SteveLRojas/LandShark/README.md

# LandShark
FPGA board for motor control applications. Compatible with the Alchemy board.
