SteveLRojas/LandShark/LandShark_ADC_Bridge/BOM.ods

Part | #Needed | #Owned | Satisfied? | Location
ADS7052 | 4 | 10 | TRUE | ADC Box
XC6219B332MR | 1 | 100 | TRUE | Regulator Box
ME6211C25M5G-N | 1 | 20 | TRUE | Regulator Box
Capacitor 10u 1206 | 3 | 100 | TRUE | Project Box
Capacitor 1u 0805 | 12 | 300 | TRUE | Box 7
Capacitor 470p 0603 | 4 | 1000 | TRUE | Small Capacitor Box
Resistor 330 ohm 0603 | 4 | 5000 | TRUE | Reel Box
Ferrite bead 0805 | 1 | 20 | TRUE | Project Box
Pin header 1x3 1.27mm | 1 | 50 | TRUE | Connector Box
Pin socket 2x20 2.54mm | 1 | 12 | TRUE | Connector Box
Pin header 2x22 2.54mm | 1 | 4 | TRUE | Connector Box
