SteveLRojas/LandShark/LandShark/BOM.ods

Part | #Needed | #Owned | Satisfied? | Location
EP4CE15E22C8N | 1 | 2 | TRUE | Project Box
AMS1117-3.3 | 1 | 5 | TRUE | Voltage Regulator Box
AMS1117-2.5 | 1 | 5 | TRUE | Voltage Regulator Box
AZ1117-1.2 | 1 | 5 | TRUE | Voltage Regulator Box
W25Q16JVSNIQ | 1 | 10 | TRUE | Project Box
75LVC1G17 | 6 | 10 | TRUE | Project Box
PMBT3906 | 4 | 1000 | TRUE | Project Box
32MHz oscillator 3225 | 1 | 10 | TRUE | Crystal Box
50MHz oscillator 3225 | 1 | 10 | TRUE | Crystal Box
FJ2481BH (Hex display) | 1 | 8 | TRUE | Project Box
LL3301NF065QG (button) | 4 | 20 | TRUE | Project Box
Test point 2.5mm 1mm | 4 | 40 | TRUE | Project Box
Capacitor 100u 6.3x5.2 | 2 | 10 | TRUE | Project Box
Capacitor 10u 1206 | 2 | 10 | TRUE | Project Box
Capacitor 47u 1206 | 2 | 10 | TRUE | Project Box
Capacitor 1u 0805 | 4 | 200 | TRUE | Box 7
Capacitor 0.1u 0805 | 33 | 100 | TRUE | Project Box
Resistor 5K6 0805 | 8 | 500 | TRUE | Box 8
Resistor 220 0805 | 8 | 4000 | TRUE | Box 8
Resistor 10K 0805 | 14 | 100 | TRUE | Box 8
Resistor 33 0805 | 2 | 20 | TRUE | Box 8
Resistor 1K 0805 | 1 | 10 | TRUE | Project Box
Socket 2.54mm 2x20 angled | 1 | 10 | TRUE | Connector Box
Socket 2.54mm 6x2 angled | 1 | 10 | TRUE | Connector Box
Pin header 2.54mm 2x5 shrouded | 2 | 10 | TRUE | Connector Box
Pin header 2.54mm 2x20 angled | 1 | 10 | TRUE | Connector Box
Pin header 2.54mm 1x5 | 2 | 20 | TRUE | Connector Box
Ferrite bead 0805 | 4 | 900 | TRUE | Project Box
