SteveLRojas/LandShark/LandShark_ADC_Bridge/LandShark_ADC_Bridge.kicad_pcb

## KiCad design LandShark_ADC_Bridge/LandShark_ADC_Bridge.kicad_pcb (2026-02-09)

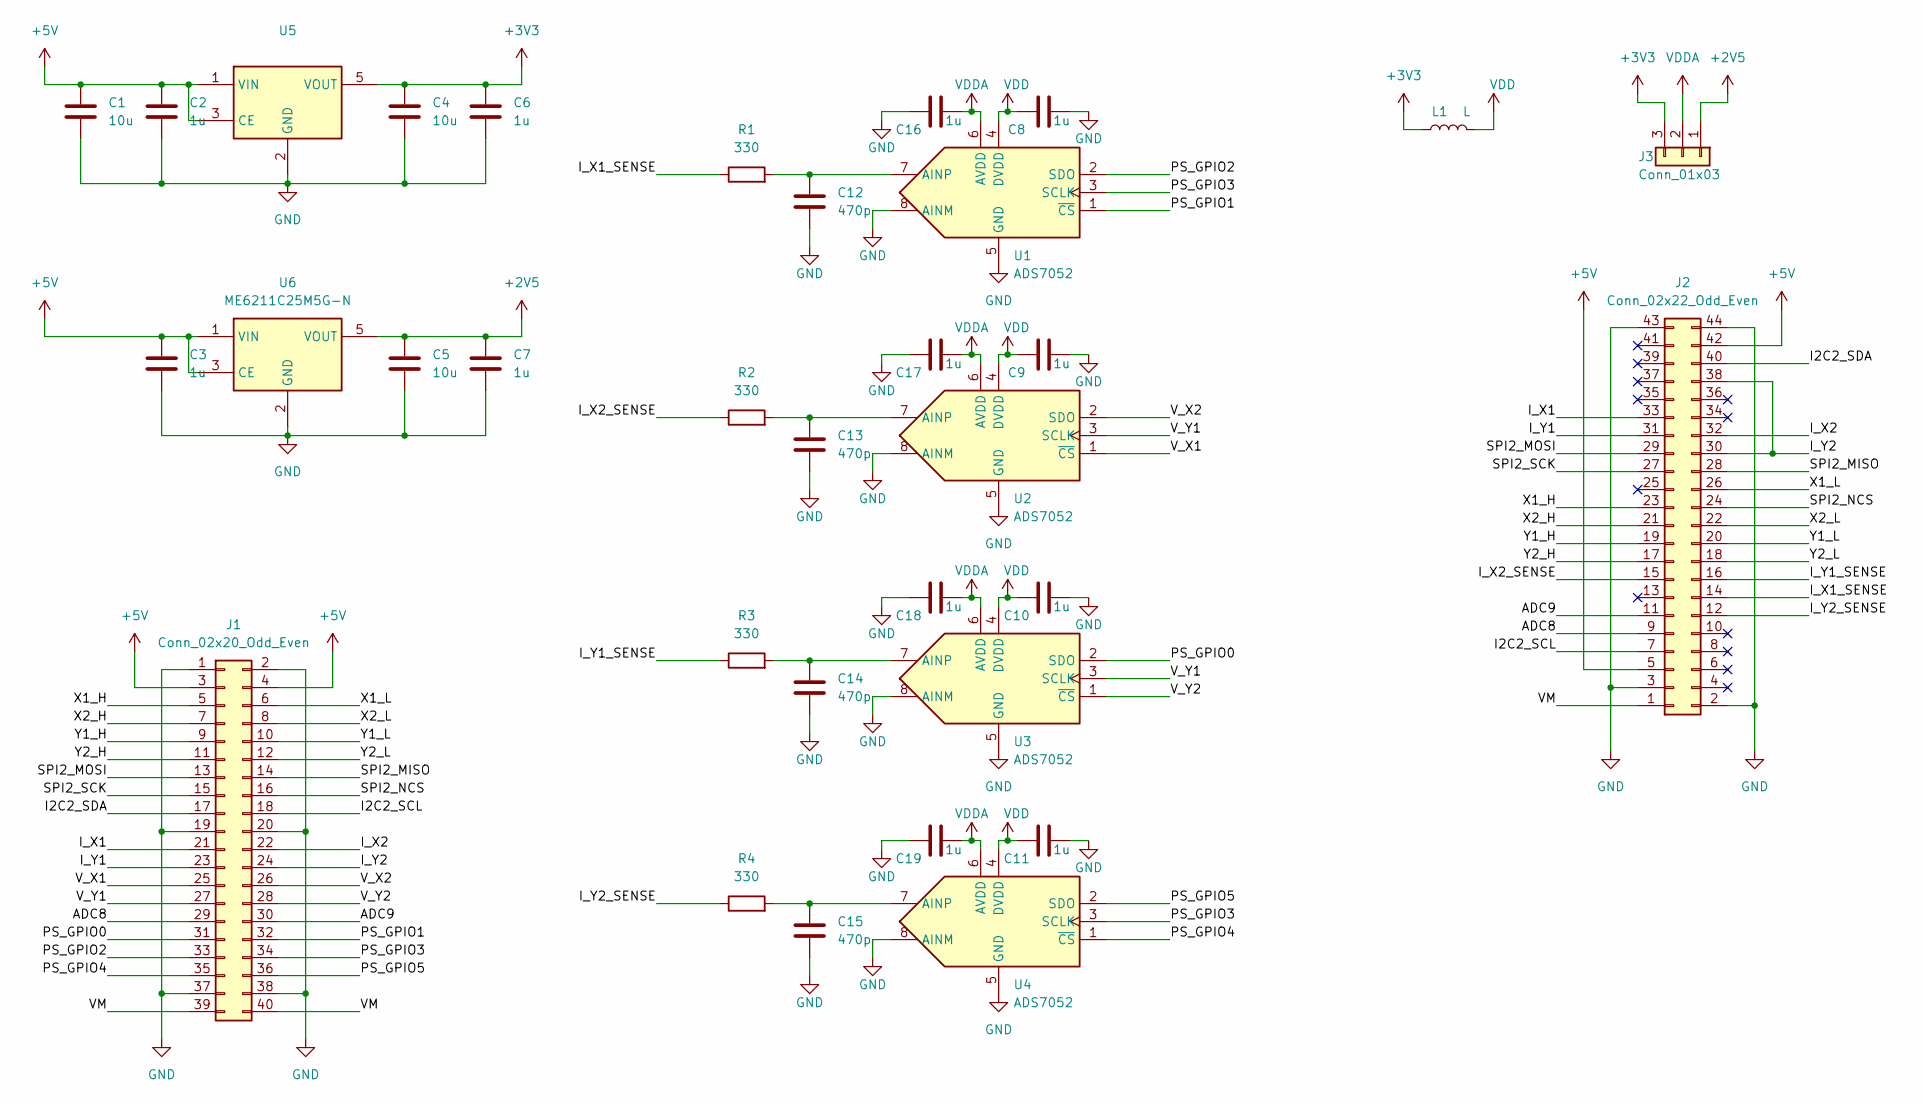
[picture p1: schematic LandShark_ADC_Bridge.kicad_sch]

Parts:
C1, C4, C5: 10u; C_1206_3216Metric
C2, C3, C6, C7, C8, C9, C10, C11, C16, C17, C18, C19: 1u; C_0805_2012Metric
C12, C13, C14, C15: 470p; C_0603_1608Metric
J1: Conn_02x20_Odd_Even; con_Alchemy_mirrored
J2: Conn_02x22_Odd_Even; PinHeader_2x22_P2.54mm_Vertical
J3: Conn_01x03; PinHeader_1x03_P1.27mm_Vertical
L1: L; L_0805_2012Metric
R1, R2, R3, R4: 330; R_0603_1608Metric
U1, U2, U3, U4: ADS7052; ADS7052IRUGR
U5: XC6219B332MR; SOT-23-5
U6: ME6211C25M5G-N; SOT-23-5

Connections:
+2V5: C5.1, C7.1, J3.1, U6.5 (VOUT)
+3V3: C4.1, C6.1, J3.3, L1.1, U5.5 (VOUT)
+5V: C1.1, C2.1, C3.1, J1.3, J1.4, J2.5, J2.42, U5.1 (VIN), U5.3 (CE), U6.1 (VIN), U6.3 (CE)
/ADC8: J1.29, J2.9
/ADC9: J1.30, J2.11
/I2C2_SCL: J1.18, J2.7
/I2C2_SDA: J1.17, J2.40
/I_X1: J1.21, J2.33
/I_X1_SENSE: J2.14, R1.1
/I_X2: J1.22, J2.32
/I_X2_SENSE: J2.15, R2.1
/I_Y1: J1.23, J2.31
/I_Y1_SENSE: J2.16, R3.1
/I_Y2: J1.24, J2.30, J2.38
/I_Y2_SENSE: J2.12, R4.1
/PS_GPIO0: J1.31, U3.2 (SDO)
/PS_GPIO1: J1.32, U1.1 (~CS)
/PS_GPIO2: J1.33, U1.2 (SDO)
/PS_GPIO3: J1.34, U1.3 (SCLK), U4.3 (SCLK)
/PS_GPIO4: J1.35, U4.1 (~CS)
/PS_GPIO5: J1.36, U4.2 (SDO)
/SPI2_MISO: J1.14, J2.28
/SPI2_MOSI: J1.13, J2.29
/SPI2_NCS: J1.16, J2.24
/SPI2_SCK: J1.15, J2.27
/VM: J1.39, J1.40, J2.1
/V_X1: J1.25, U2.1 (~CS)
/V_X2: J1.26, U2.2 (SDO)
/V_Y1: J1.27, U2.3 (SCLK), U3.3 (SCLK)
/V_Y2: J1.28, U3.1 (~CS)
/X1_H: J1.5, J2.23
/X1_L: J1.6, J2.26
/X2_H: J1.7, J2.21
/X2_L: J1.8, J2.22
/Y1_H: J1.9, J2.19
/Y1_L: J1.10, J2.20
/Y2_H: J1.11, J2.17
/Y2_L: J1.12, J2.18
GND: C1.2, C2.2, C3.2, C4.2, C5.2, C6.2, C7.2, C8.2, C9.2, C10.2, C11.2, C12.1, C13.1, C14.1, C15.1, C16.1, C17.1, C18.1, C19.1, J1.1, J1.2, J1.19, J1.20, J1.37, J1.38, J2.2, J2.3, J2.43, J2.44, U1.5 (GND), U1.8 (AINM), U2.5 (GND), U2.8 (AINM), U3.5 (GND), U3.8 (AINM), U4.5 (GND), U4.8 (AINM), U5.2 (GND), U6.2 (GND)
unnamed: C12.2, R1.2, U1.7 (AINP)
unnamed: C13.2, R2.2, U2.7 (AINP)
unnamed: C14.2, R3.2, U3.7 (AINP)
unnamed: C15.2, R4.2, U4.7 (AINP)
VDD: C8.1, C9.1, C10.1, C11.1, L1.2, U1.4 (DVDD), U2.4 (DVDD), U3.4 (DVDD), U4.4 (DVDD)
VDDA: C16.2, C17.2, C18.2, C19.2, J3.2, U1.6 (AVDD), U2.6 (AVDD), U3.6 (AVDD), U4.6 (AVDD)

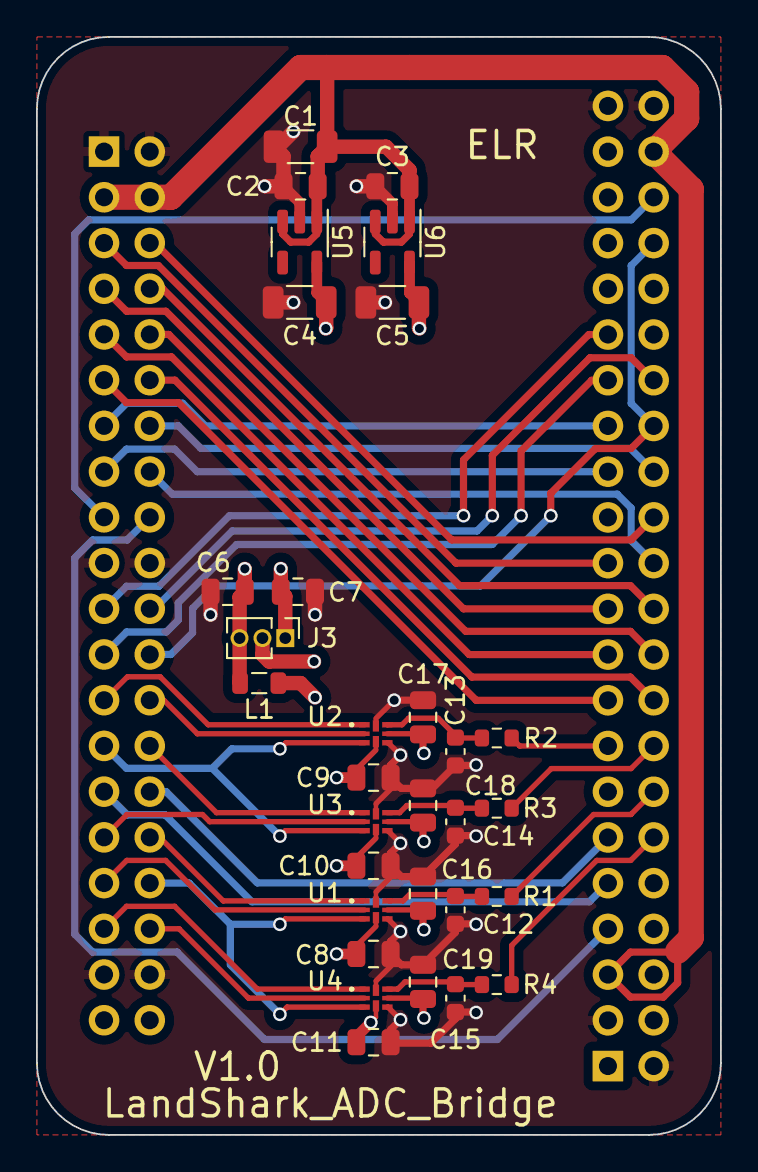
[picture p2: board LandShark_ADC_Bridge.kicad_pcb from above]

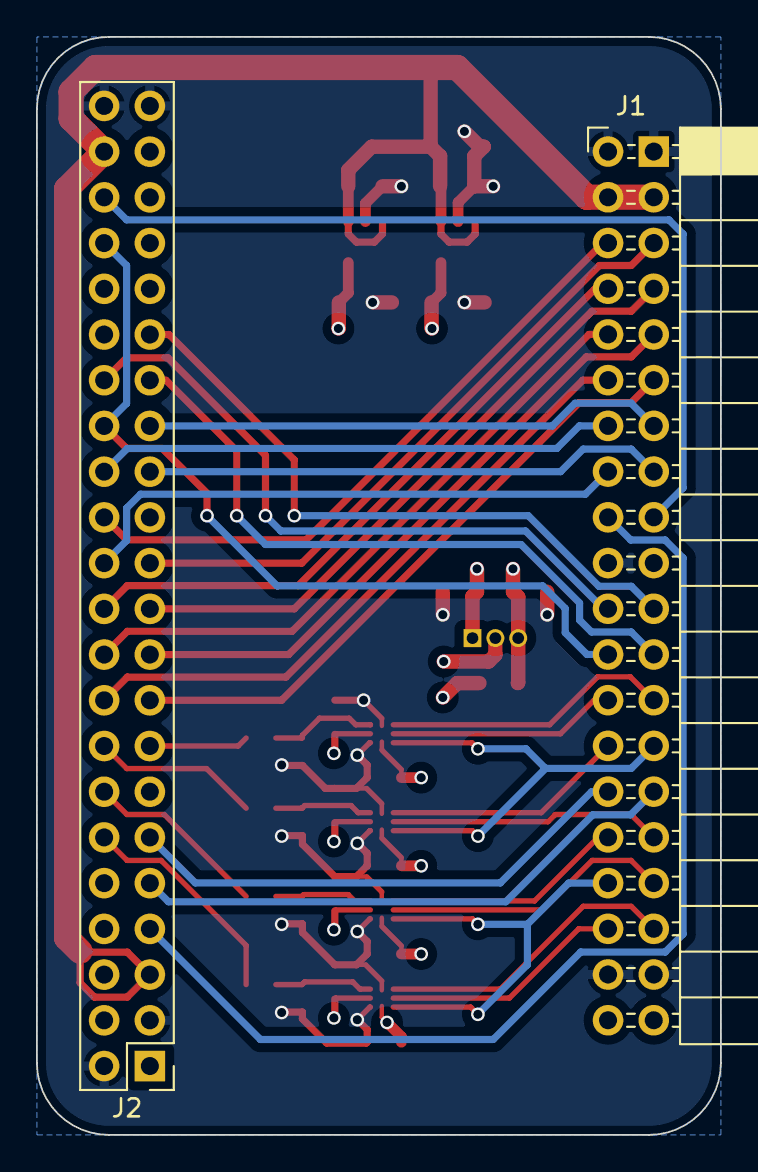
[picture p3: board LandShark_ADC_Bridge.kicad_pcb from below]

Board: 4 copper layers, 38.0 x 61.0 mm, 33 parts (2 on the bottom side), 45 nets.
