SteveLRojas/LandShark/LandShark/LandShark.kicad_pcb

## KiCad design LandShark/LandShark.kicad_pcb (2025-06-05)

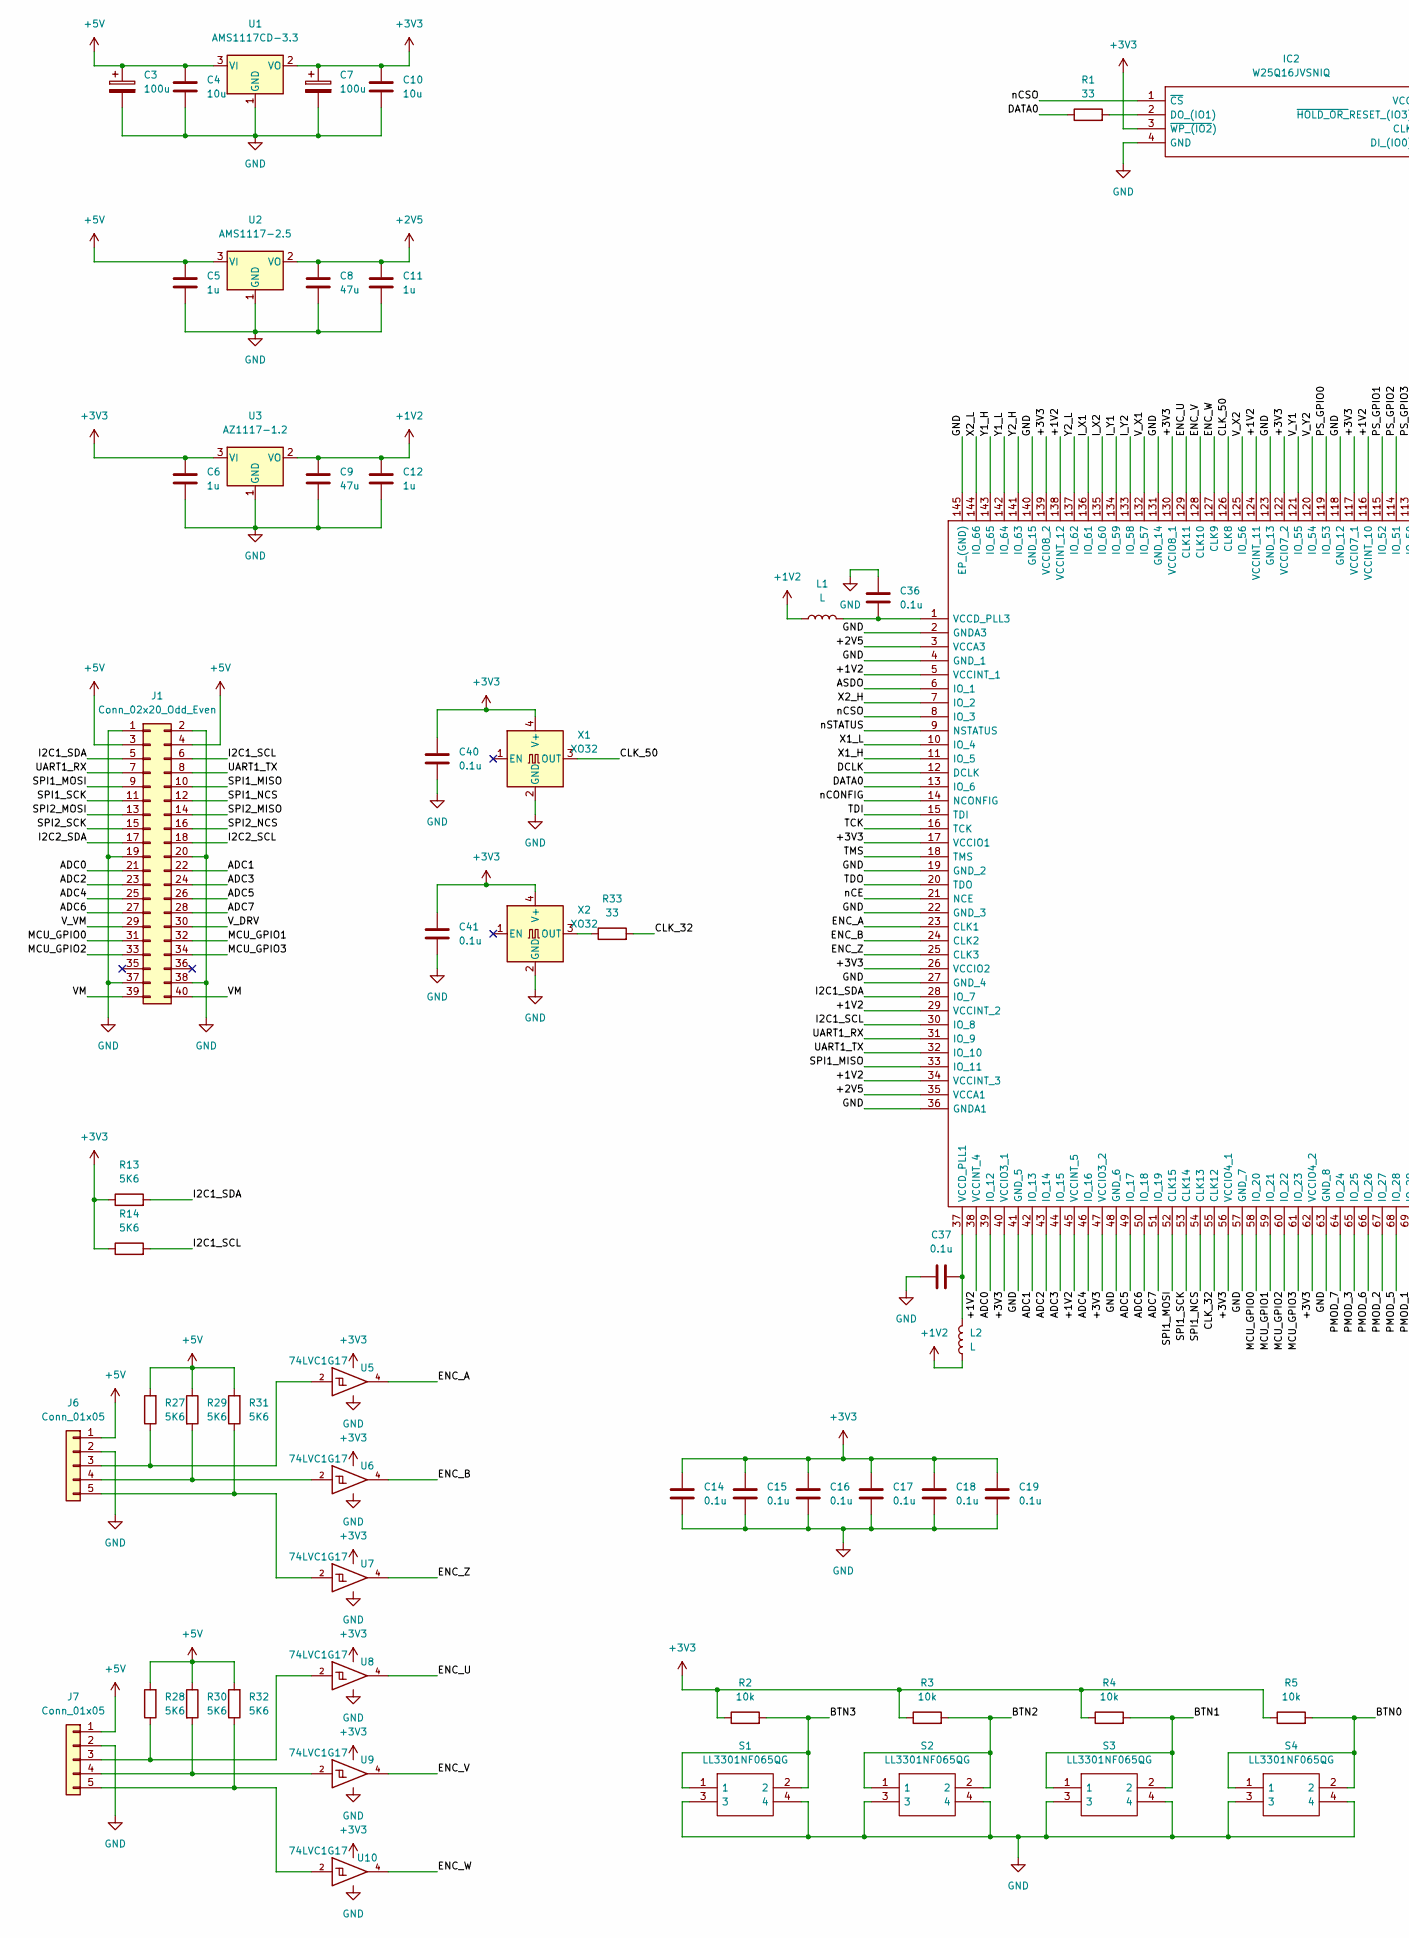
[picture p4: schematic LandShark.kicad_sch, part in row 1, column 1]

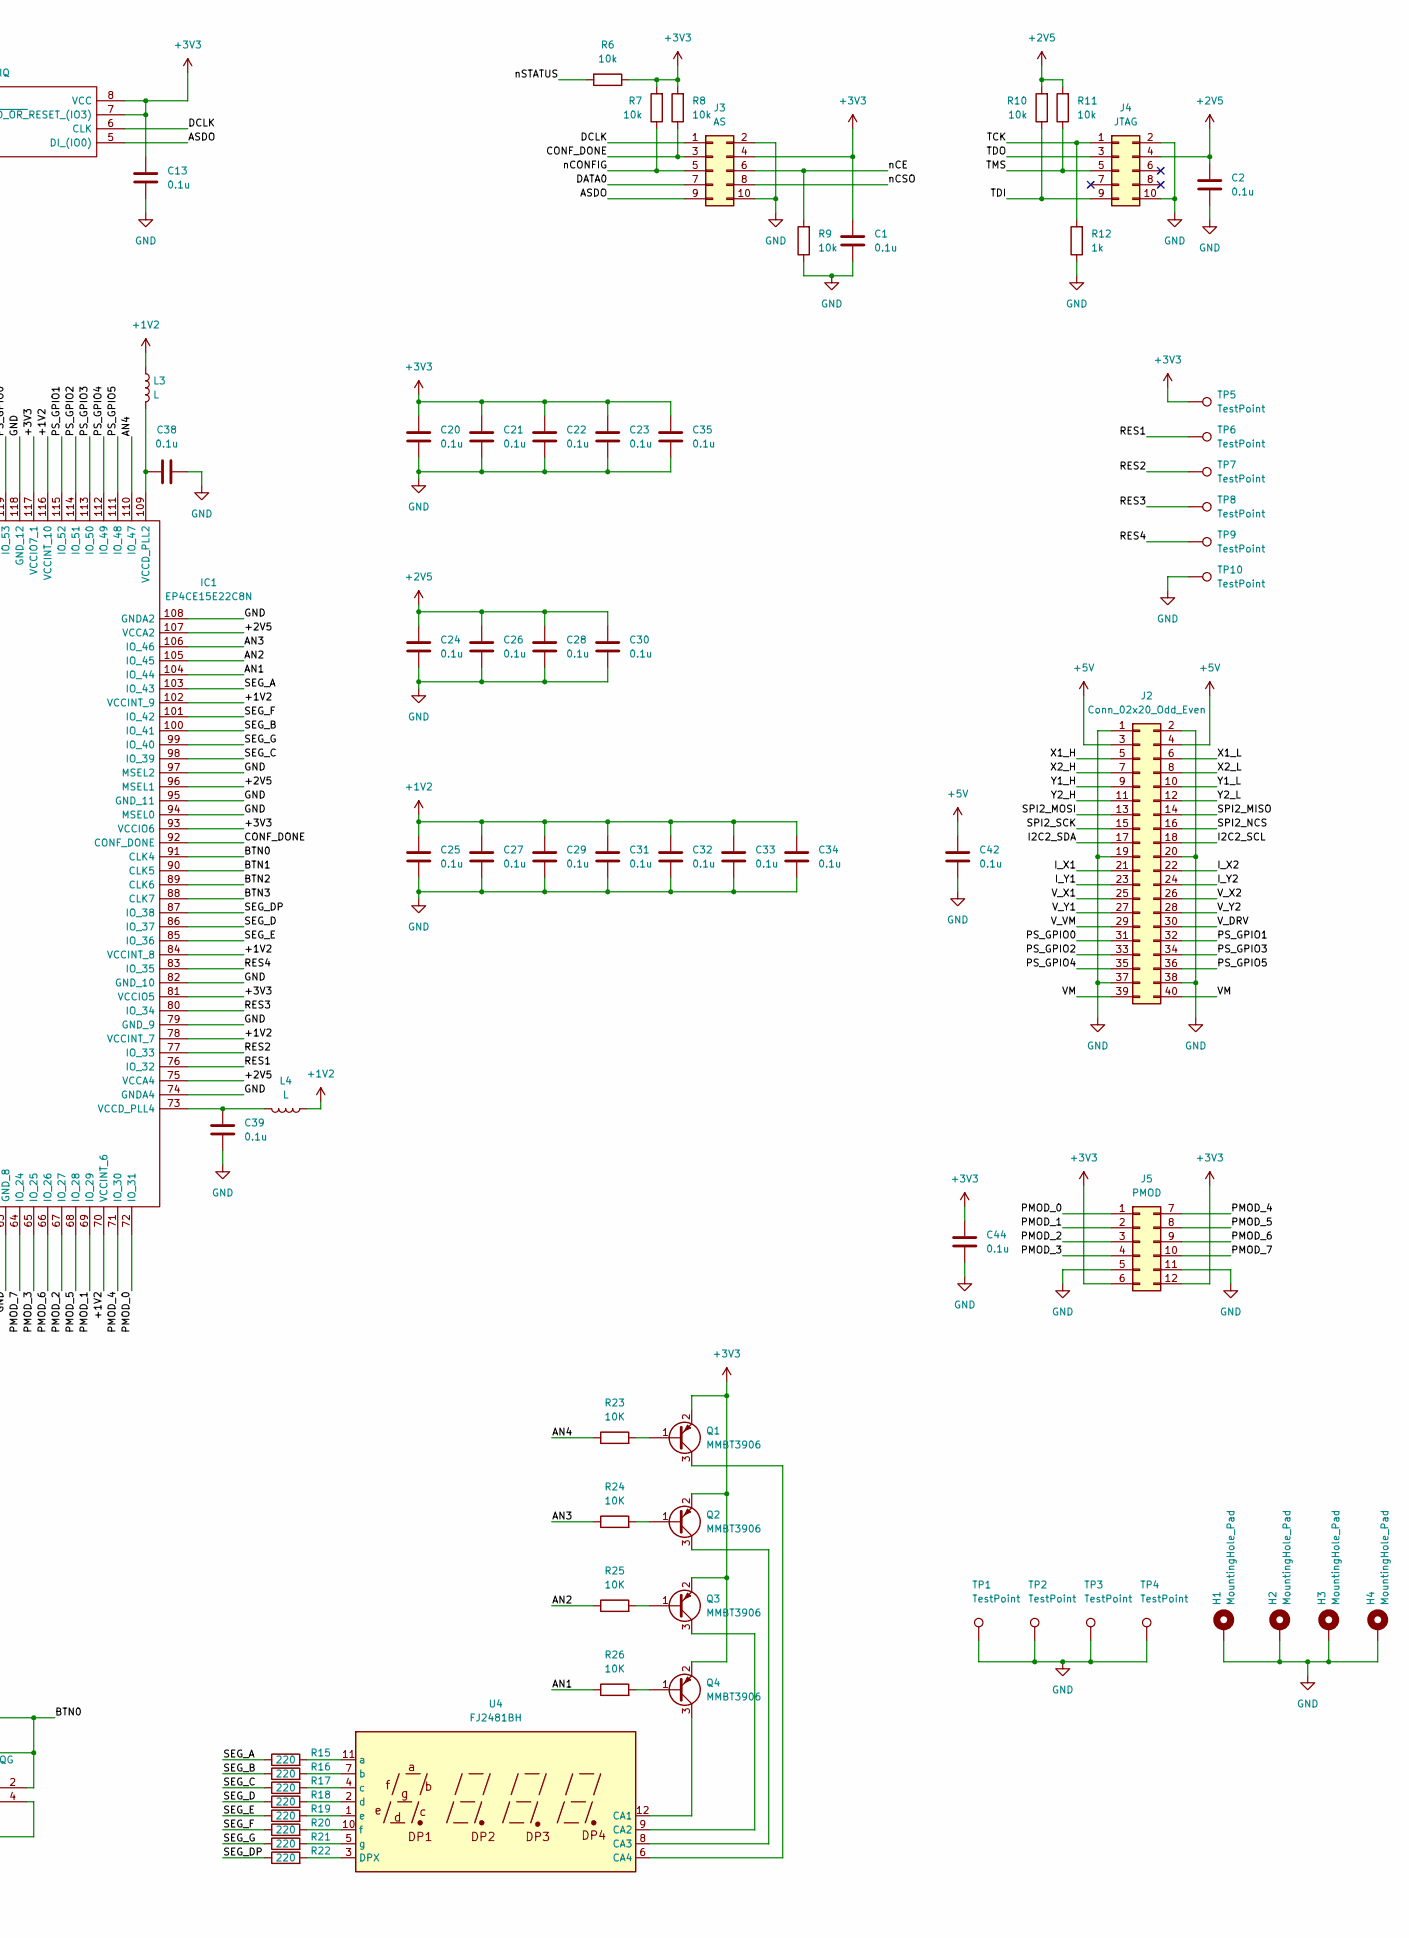
[picture p5: schematic LandShark.kicad_sch, part in row 1, column 2]

Parts:
C1, C2, C13, C14, C15, C16, C17, C18, C19, C20, C21, C22, C23, C24, C25, C26, C27, C28, C29, C30, C31, C32, C33, C34, C35, C36, C37, C38, C39, C40, C41, C42, C44: 0.1u; C_0805_2012Metric
C3, C7: 100u; CP_Elec_6.3x5.2
C4, C10: 10u; C_1206_3216Metric
C5, C6, C11, C12: 1u; C_0805_2012Metric
C8, C9: 47u; C_1206_3216Metric
H1, H2, H3, H4: MountingHole_Pad; MountingHole_3.2mm_M3_Pad
IC1: EP4CE15E22C8N; QFP50P2200X2200X165-145N; Mouser Part Number 989-EP4CE15E22C8N
IC2: W25Q16JVSNIQ; SOIC127P600X175-8N; Manufacturer_Part_Number W25Q16JVSNIQ; Mouser Part Number 454-W25Q16JVSNIQ
J1: Conn_02x20_Odd_Even; PinSocket_2x20_P2.54mm_Horizontal
J2: Conn_02x20_Odd_Even; PinHeader_2x20_P2.54mm_Horizontal
J3: AS; IDC-Header_2x05_P2.54mm_Vertical
J4: JTAG; IDC-Header_2x05_P2.54mm_Vertical
J5: PMOD; pmod_socket_6x2
J6, J7: Conn_01x05; PinHeader_1x05_P2.54mm_Vertical
L1, L2, L3, L4: L; L_0805_2012Metric
Q1, Q2, Q3, Q4: MMBT3906; SOT-23
R1, R33: 33; R_0805_2012Metric
R2, R3, R4, R5, R6, R7, R8, R9, R10, R11: 10k; R_0805_2012Metric
R12: 1k; R_0805_2012Metric
R13, R14, R27, R28, R29, R30, R31, R32: 5K6; R_0805_2012Metric
R15, R16, R17, R18, R19, R20, R21, R22: 220; R_0805_2012Metric
R23, R24, R25, R26: 10K; R_0805_2012Metric
S1, S2, S3, S4: LL3301NF065QG; Mouser Part Number 612-LL3301NF065QG
TP1, TP2, TP3, TP4: TestPoint; TestPoint_Loop_D2.50mm_Drill1.0mm
TP5, TP6, TP7, TP8, TP9, TP10: TestPoint; TestPoint_Pad_1.5x1.5mm
U1: AMS1117CD-3.3; TO-252-3_TabPin2
U2: AMS1117-2.5; SOT-223-3_TabPin2
U3: AZ1117-1.2; SOT-223-3_TabPin2
U4: FJ2481BH
U5, U6, U7, U8, U9, U10: 74LVC1G17; SOT-353_SC-70-5
X1, X2: XO32; Oscillator_SMD_EuroQuartz_XO32-4Pin_3.2x2.5mm

Connections:
+1V2: C9.1, C12.1, C25.1, C27.1, C29.1, C31.1, C32.1, C33.1, C34.1, IC1.5 (VCCINT_1), IC1.29 (VCCINT_2), IC1.34 (VCCINT_3), IC1.38 (VCCINT_4), IC1.45 (VCCINT_5), IC1.70 (VCCINT_6), IC1.78 (VCCINT_7), IC1.84 (VCCINT_8), IC1.102 (VCCINT_9), IC1.116 (VCCINT_10), IC1.124 (VCCINT_11), IC1.138 (VCCINT_12), L1.1, L2.1, L3.1, L4.1, U3.2 (VO)
+2V5: C2.1, C8.1, C11.1, C24.1, C26.1, C28.1, C30.1, IC1.3 (VCCA3), IC1.35 (VCCA1), IC1.75 (VCCA4), IC1.96 (MSEL1), IC1.107 (VCCA2), J4.4, R10.2, R11.2, U2.2 (VO)
+3V3: C1.1, C6.1, C7.1, C10.1, C13.1, C14.1, C15.1, C16.1, C17.1, C18.1, C19.1, C20.1, C21.1, C22.1, C23.1, C35.1, C40.1, C41.1, C44.1, IC1.17 (VCCIO1), IC1.26 (VCCIO2), IC1.40 (VCCIO3_1), IC1.47 (VCCIO3_2), IC1.56 (VCCIO4_1), IC1.62 (VCCIO4_2), IC1.81 (VCCIO5), IC1.93 (VCCIO6), IC1.117 (VCCIO7_1), IC1.122 (VCCIO7_2), IC1.130 (VCCIO8_1), IC1.139 (VCCIO8_2), IC2.3 (~WP_(IO2)), IC2.7 (~HOLD_OR_RESET_(IO3)), IC2.8 (VCC), J3.4, J5.6, J5.12, Q1.2 (E), Q2.2 (E), Q3.2 (E), Q4.2 (E), R2.1, R3.1, R4.1, R5.1, R6.1, R7.2, R8.2, R13.1, R14.1, TP5.1, U1.2 (VO), U3.3 (VI), U5.5 (VCC), U6.5 (VCC), U7.5 (VCC), U8.5 (VCC), U9.5 (VCC), U10.5 (VCC), X1.4 (V+), X2.4 (V+)
+5V: C3.1, C4.1, C5.1, C42.1, J1.3, J1.4, J2.3, J2.4, J6.1, J7.1, R27.2, R28.2, R29.1, R30.1, R31.2, R32.2, U1.3 (VI), U2.3 (VI)
/ADC0: IC1.39 (IO_12), J1.21
/ADC1: IC1.42 (IO_13), J1.22
/ADC2: IC1.43 (IO_14), J1.23
/ADC3: IC1.44 (IO_15), J1.24
/ADC4: IC1.46 (IO_16), J1.25
/ADC5: IC1.49 (IO_17), J1.26
/ADC6: IC1.50 (IO_18), J1.27
/ADC7: IC1.51 (IO_19), J1.28
/AN1: IC1.104 (IO_44), R26.1
/AN2: IC1.105 (IO_45), R25.1
/AN3: IC1.106 (IO_46), R24.1
/AN4: IC1.110 (IO_47), R23.1
/ASDO: IC1.6 (IO_1), IC2.5 (DI_(IO0)), J3.9
/BTN0: IC1.91 (CLK4), R5.2, S4.1, S4.2
/BTN1: IC1.90 (CLK5), R4.2, S3.1, S3.2
/BTN2: IC1.89 (CLK6), R3.2, S2.1, S2.2
/BTN3: IC1.88 (CLK7), R2.2, S1.1, S1.2
/CLK_32: IC1.55 (CLK12), R33.2
/CLK_50: IC1.126 (CLK8), X1.3 (OUT)
/CONF_DONE: IC1.92 (CONF_DONE), J3.3, R8.1
/DATA0: IC1.13 (IO_6), J3.7, R1.1
/DCLK: IC1.12 (DCLK), IC2.6 (CLK), J3.1
/ENC_A: IC1.23 (CLK1), U5.4
/ENC_B: IC1.24 (CLK2), U6.4
/ENC_U: IC1.129 (CLK11), U8.4
/ENC_V: IC1.128 (CLK10), U9.4
/ENC_W: IC1.127 (CLK9), U10.4
/ENC_Z: IC1.25 (CLK3), U7.4
/I2C1_SCL: IC1.30 (IO_8), J1.6, R14.2
/I2C1_SDA: IC1.28 (IO_7), J1.5, R13.2
/I2C2_SCL: J1.18, J2.18
/I2C2_SDA: J1.17, J2.17
/I_X1: IC1.136 (IO_61), J2.21
/I_X2: IC1.135 (IO_60), J2.22
/I_Y1: IC1.134 (IO_59), J2.23
/I_Y2: IC1.133 (IO_58), J2.24
/MCU_GPIO0: IC1.58 (IO_20), J1.31
/MCU_GPIO1: IC1.59 (IO_21), J1.32
/MCU_GPIO2: IC1.60 (IO_22), J1.33
/MCU_GPIO3: IC1.61 (IO_23), J1.34
/PMOD_0: IC1.72 (IO_31), J5.1
/PMOD_1: IC1.69 (IO_29), J5.2
/PMOD_2: IC1.67 (IO_27), J5.3
/PMOD_3: IC1.65 (IO_25), J5.4
/PMOD_4: IC1.71 (IO_30), J5.7
/PMOD_5: IC1.68 (IO_28), J5.8
/PMOD_6: IC1.66 (IO_26), J5.9
/PMOD_7: IC1.64 (IO_24), J5.10
/PS_GPIO0: IC1.119 (IO_53), J2.31
/PS_GPIO1: IC1.115 (IO_52), J2.32
/PS_GPIO2: IC1.114 (IO_51), J2.33
/PS_GPIO3: IC1.113 (IO_50), J2.34
/PS_GPIO4: IC1.112 (IO_49), J2.35
/PS_GPIO5: IC1.111 (IO_48), J2.36
/RES1: IC1.76 (IO_32), TP6.1
/RES2: IC1.77 (IO_33), TP7.1
/RES3: IC1.80 (IO_34), TP8.1
/RES4: IC1.83 (IO_35), TP9.1
/SEG_A: IC1.103 (IO_43), R15.1
/SEG_B: IC1.100 (IO_41), R16.1
/SEG_C: IC1.98 (IO_39), R17.1
/SEG_D: IC1.86 (IO_37), R18.1
/SEG_DP: IC1.87 (IO_38), R22.1
/SEG_E: IC1.85 (IO_36), R19.1
/SEG_F: IC1.101 (IO_42), R20.1
/SEG_G: IC1.99 (IO_40), R21.1
/SPI1_MISO: IC1.33 (IO_11), J1.10
/SPI1_MOSI: IC1.52 (CLK15), J1.9
/SPI1_NCS: IC1.54 (CLK13), J1.12
/SPI1_SCK: IC1.53 (CLK14), J1.11
/SPI2_MISO: J1.14, J2.14
/SPI2_MOSI: J1.13, J2.13
/SPI2_NCS: J1.16, J2.16
/SPI2_SCK: J1.15, J2.15
/TCK: IC1.16 (TCK), J4.1, R12.2
/TDI: IC1.15 (TDI), J4.9, R10.1
/TDO: IC1.20 (TDO), J4.3
/TMS: IC1.18 (TMS), J4.5, R11.1
/UART1_RX: IC1.31 (IO_9), J1.7
/UART1_TX: IC1.32 (IO_10), J1.8
/VM: J1.39, J1.40, J2.39, J2.40
/V_DRV: J1.30, J2.30
/V_VM: J1.29, J2.29
/V_X1: IC1.132 (IO_57), J2.25
/V_X2: IC1.125 (IO_56), J2.26
/V_Y1: IC1.121 (IO_55), J2.27
/V_Y2: IC1.120 (IO_54), J2.28
/X1_H: IC1.11 (IO_5), J2.5
/X1_L: IC1.10 (IO_4), J2.6
/X2_H: IC1.7 (IO_2), J2.7
/X2_L: IC1.144 (IO_66), J2.8
/Y1_H: IC1.143 (IO_65), J2.9
/Y1_L: IC1.142 (IO_64), J2.10
/Y2_H: IC1.141 (IO_63), J2.11
/Y2_L: IC1.137 (IO_62), J2.12
/nCE: IC1.21 (NCE), J3.6, R9.2
/nCONFIG: IC1.14 (NCONFIG), J3.5, R7.1
/nCSO: IC1.8 (IO_3), IC2.1 (~CS), J3.8
/nSTATUS: IC1.9 (NSTATUS), R6.2
GND: C1.2, C2.2, C3.2, C4.2, C5.2, C6.2, C7.2, C8.2, C9.2, C10.2, C11.2, C12.2, C13.2, C14.2, C15.2, C16.2, C17.2, C18.2, C19.2, C20.2, C21.2, C22.2, C23.2, C24.2, C25.2, C26.2, C27.2, C28.2, C29.2, C30.2, C31.2, C32.2, C33.2, C34.2, C35.2, C36.2, C37.2, C38.2, C39.1, C40.2, C41.2, C42.2, C44.2, H1.1, H2.1, H3.1, H4.1, IC1.2 (GNDA3), IC1.4 (GND_1), IC1.19 (GND_2), IC1.22 (GND_3), IC1.27 (GND_4), IC1.36 (GNDA1), IC1.41 (GND_5), IC1.48 (GND_6), IC1.57 (GND_7), IC1.63 (GND_8), IC1.74 (GNDA4), IC1.79 (GND_9), IC1.82 (GND_10), IC1.94 (MSEL0), IC1.95 (GND_11), IC1.97 (MSEL2), IC1.108 (GNDA2), IC1.118 (GND_12), IC1.123 (GND_13), IC1.131 (GND_14), IC1.140 (GND_15), IC1.145 (EP_(GND)), IC2.4 (GND), J1.1, J1.2, J1.19, J1.20, J1.37, J1.38, J2.1, J2.2, J2.19, J2.20, J2.37, J2.38, J3.2, J3.10, J4.2, J4.10, J5.5, J5.11, J6.2, J7.2, R9.1, R12.1, S1.3, S1.4, S2.3, S2.4, S3.3, S3.4, S4.3, S4.4, TP1.1, TP2.1, TP3.1, TP4.1, TP10.1, U1.1 (GND), U2.1 (GND), U3.1 (GND), U5.3 (GND), U6.3 (GND), U7.3 (GND), U8.3 (GND), U9.3 (GND), U10.3 (GND), X1.2 (GND), X2.2 (GND)
unnamed: C36.1, IC1.1 (VCCD_PLL3), L1.2
unnamed: C37.1, IC1.37 (VCCD_PLL1), L2.2
unnamed: C39.2, IC1.73 (VCCD_PLL4), L4.2
unnamed: C38.1, IC1.109 (VCCD_PLL2), L3.2
unnamed: IC2.2 (DO_(IO1)), R1.2
unnamed: J6.3, R27.1, U5.2
unnamed: J6.4, R29.2, U6.2
unnamed: J6.5, R31.1, U7.2
unnamed: J7.3, R28.1, U8.2
unnamed: J7.4, R30.2, U9.2
unnamed: J7.5, R32.1, U10.2
unnamed: Q1.1 (B), R23.2
unnamed: Q1.3 (C), U4.6 (CA4)
unnamed: Q2.1 (B), R24.2
unnamed: Q2.3 (C), U4.8 (CA3)
unnamed: Q3.1 (B), R25.2
unnamed: Q3.3 (C), U4.9 (CA2)
unnamed: Q4.1 (B), R26.2
unnamed: Q4.3 (C), U4.12 (CA1)
unnamed: R15.2, U4.11 (a)
unnamed: R16.2, U4.7 (b)
unnamed: R17.2, U4.4 (c)
unnamed: R18.2, U4.2 (d)
unnamed: R19.2, U4.1 (e)
unnamed: R20.2, U4.10 (f)
unnamed: R21.2, U4.5 (g)
unnamed: R22.2, U4.3 (DPX)
unnamed: R33.1, X2.3 (OUT)

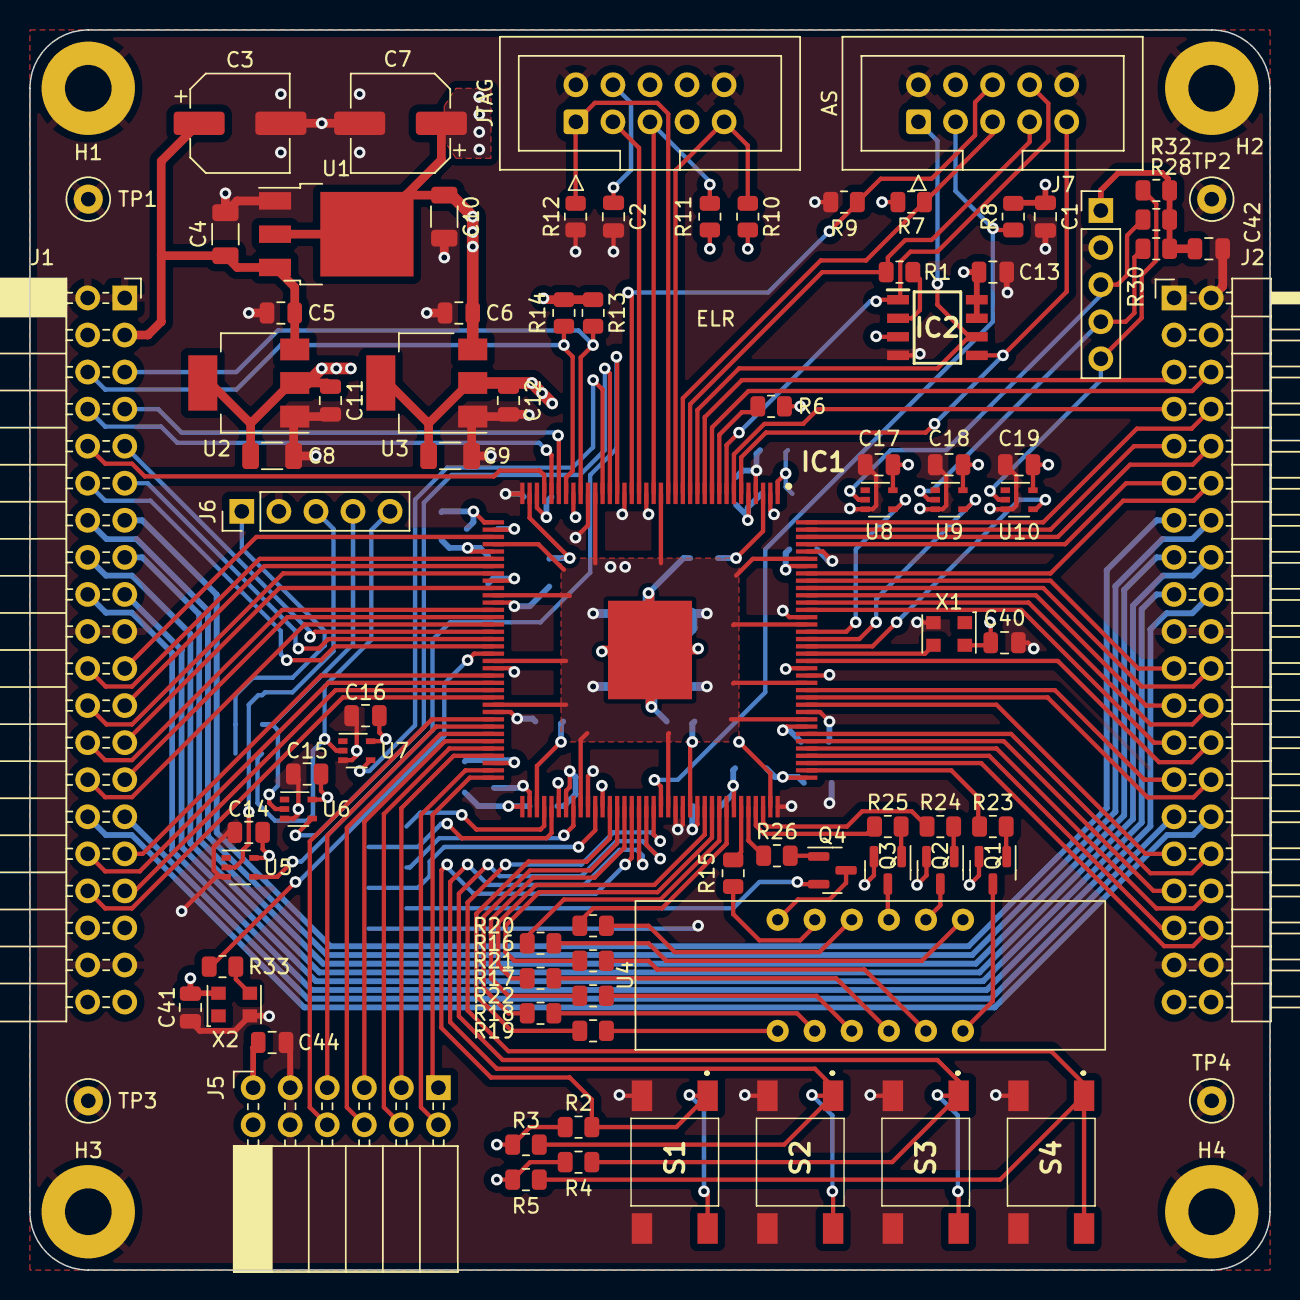
[picture p6: board LandShark.kicad_pcb from above]

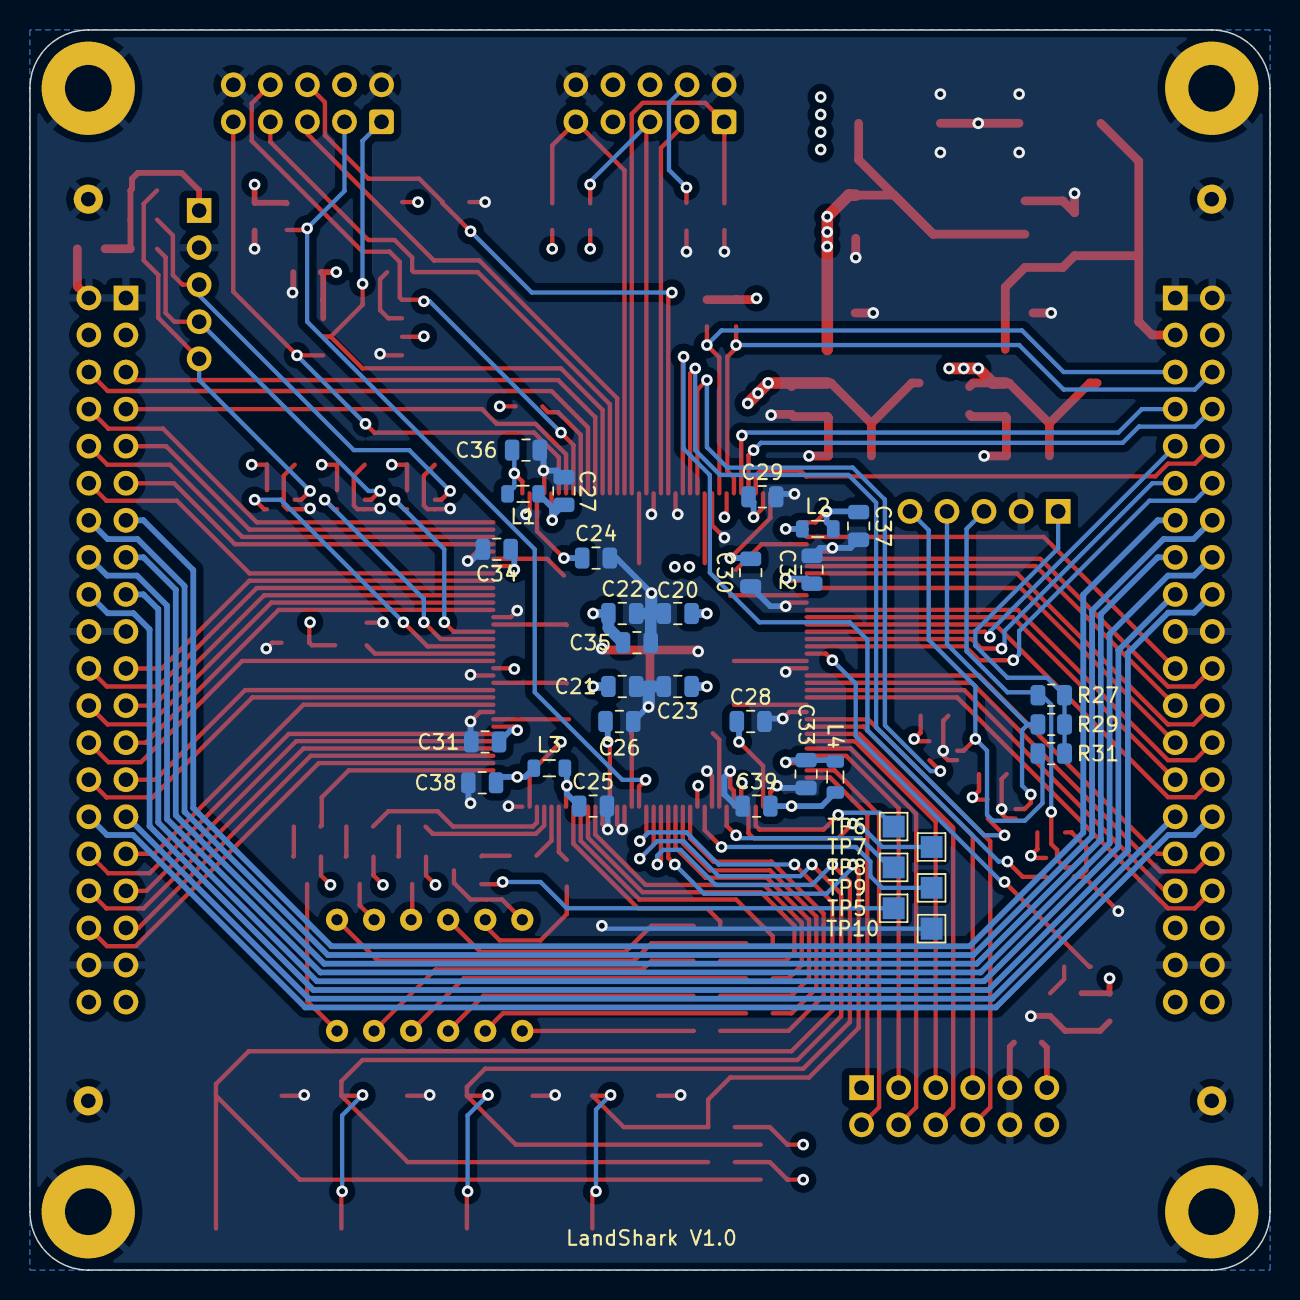
[picture p7: board LandShark.kicad_pcb from below]

Board: 4 copper layers, 85.0 x 85.0 mm, 123 parts (33 on the bottom side), 132 nets.
