SteveLRojas/LandShark/(commit log)

2025-06-05 Added design files
    [BOM.ods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]
2026-02-09 Added LandShark_ADC_Bridge
    [BOM.ods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]
